AlpenglowIndustries/Alpenglow-SkeinTwister/README.md

# Alpenglow-SkeinTwister
The main open-source hardware repo for the Alpenglow Yarn SkeinTwister.  Start here, repo for the SkeinTwister software is [here](https://github.com/AlpenglowIndustries/SkeinTwisterCode).



Hello my friends.  As one of the final acts of Alpenglow Industries, we are open-sourcing the SkeinTwister design under a permissive CERN open hardware v2 license.  The text of the license is included in this repo, what it practically means is that as long as you attribute our original work, you can reproduce anything in this repo and even sell it.  

The [Alpenglow YouTube channel](https://www.youtube.com/watch?v=4FvFv4GcJJE&list=PLGswnsgctcE1kCAfXg5c3xEA6l_XDLfXw&pp=sAgC) has videos on assembly/disassembly and repair.

Note that we were purchasing parts and materials in large batches, so our sources that are listed in the SkeinTwister BOM spreadsheet may or may not be relevant for you. Use it as a starting point. The ReadMe docs in each folder will have more info about the parts that folder describes.

If you would like to reproduce this design and need help, Carrie Sundra is available to hire for consulting and for manufacturing the custom circuit boards.  You can reach out to her via [Discord](https://discord.com/users/461976578734161920) or [this email](mailto:info@alpenglowyarn.com) for now.  She is willing to do one free 30 minute video chat with anyone who is interested in reproducing the design, after that she may have time available at her hourly consulting rate.
