AlpenglowIndustries/Alpenglow-SkeinTwister/SkeinTwister Motor/ReadMe for Motors.txt

We purchased motors directly from Tsiny, qtys of about 144 at a time.  You can find the same part number on AliExpress purchaseable in small quantities.  They may not have the extra gearbox grease we had them add to the motors we purchased.

We developed a few custom specs for these motor orders:
Motor name: TS-40GZ868-motors-12V 160rpm
Special requirements: multi-point grease coated on the gear box
Packaging: Please ship with the same packaging - 6 motors per tray, no more than 4 trays (24 motors) per box.  Please also make sure that excess room in the box is taken up by material that cannot be further compressed, so that motors cannot move in the box during shipping.
Qty: 144 

Contact:
Avril Luo
Dongguan Tsiny Motor IND CO.,LTD
sales@tsinymotor.com
+86-0769-87736501 / +86-18664005397
www.tsinymotor.com
