AlpenglowIndustries/Alpenglow-SkeinTwister/SkeinTwister Foot Pedal/NewWirePath.jpg

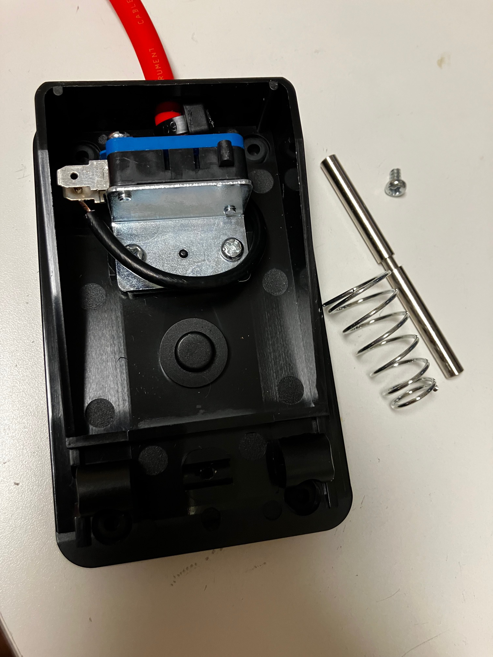
SkeinTwister Foot Pedal/NewWirePath.jpg
