AlpenglowIndustries/Alpenglow-SkeinTwister/SkeinTwister Motor/Tsiny Motor Specs 40GZ868 highlighted.JPG

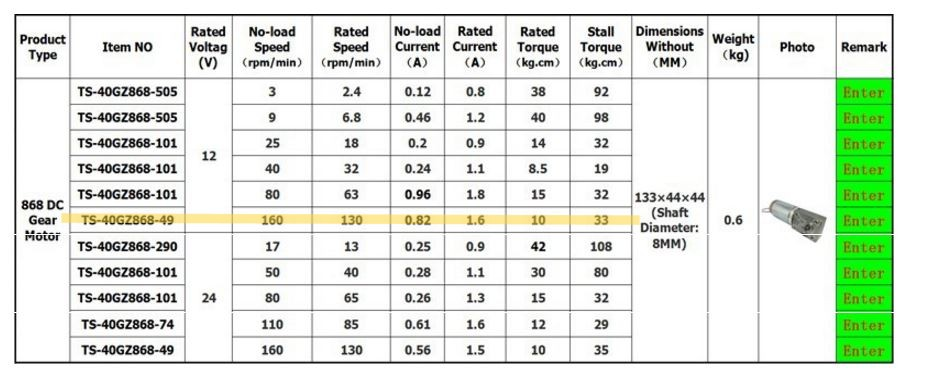
SkeinTwister Motor/Tsiny Motor Specs 40GZ868 highlighted.JPG
