AlpenglowIndustries/Alpenglow-SkeinTwister/SkeinTwister PCB/ST01P01E BOM for JLC.xlsx

Sheet: LCSCBOM
Designator | Type | Footprint | Comment | Quantity | Manufacturer | Manufacturer P/N | Supplier | Supplier P/N | DNP | JLCPCB Part # |  | Basic Man P/N | Basic P/N | Alternate from Macrofab BOM
C2, C3, C5, C6, C7, C9 | CAP | 603 | 0.1 uF capacitor, 10%, 25V, X7R, 0603 pkg | 6 | Samsung | CL10B104KA8NNWC | Digi-Key | 1276-1932-1-ND |  | C14663 | ok to sub | CC0603KRX7R9BB104 | C14663
C1 | CAP | 603 | 1.0 uF capacitor, 10%, 25V, X7R, 0603 | 1 | Samsung | CL10B105KA8NNNC | Digi-Key | 1276-1184-1-ND |  | C15849 | X5R | CL10A105KB8NNNC | C15849
C4 | CAP | 603 | 10 uF capacitor, 10%, 16V, X5R, 0603 | 1 | Murata | GRM188C81C106MA73D | Digi-Key | 490-7198-1-ND |  | C96446 | 25V X5R 10% | CL10A106MA8NRNC | C96446
C8 | CAP | CAP-10MM | 820 uF capacitor, aluminum electrolytic, 25V, 2000 hrs, 595 mA ripple, 20%, 0.394" dia x 0.413" height, smt | 1 | Nichicon | UCM1E821MNL1GS | Digi-Key | 493-14532-1-ND |  | C401766 | ok to sub | EEEFT1E102UP | C401766 | UCM1E821MNL1GS
J2 | CONN | CONN-JACK-2MM_-_SLOTS | 2.5mm x 5.5mm barrel jack, thru-hole pkg | 1 | CUI | PJ-066B | Digi-Key | PJ-066B |  | C500101 | ok to sub | DC-025LBM-5A-2.5 | C500101 | DC-025LM-5A-2.5 | C500102
J4 | CONN | AUDIO-6.35MM-RTA | 1/4" stereo audio jack with switches for plug detection, thru-hole pkg (0.25 ea for 1000 on alibaba) | 1 | Yueqing Binrong Electric Co Ltd | JP-611 | Alibaba | JP-611 |  | C309278 | ok to sub | PJ-611 | C309278
J5 | CONN | DF13C-3P-1.25V | 3-pos DF13 series connector, smt, vertical | 1 | Hirose | DF13C-3P-1.25V(51) | Digi-Key | H121960CT-ND |  | C88352 | ok to sub | DF13C-3P-1.25V(21) | C88352
J1 | CONN | DF13C-6P-1.25V | 6-pos DF13 series connector, smt, vertical | 1 | Hirose | DF13C-6P-1.25V(20) | Digi-Key | H3423-ND |  | C116888
J6 | CONN | OSTTE021104 | Terminal block, 10A, through hole, 2-pos | 1 | On Shore | OSTTE021104 | Digi-Key | ED2748-ND |  | C3817188 | not in stock
J3 | CONN | JST-XH-3 | 3-pos XH series connector, male pins, straight, thru-hole pkg | 1 | JST | B3B-XH-A(LF)(SN) | Digi-Key | 455-2248-ND |  | C144394
D4 | DIODE | SOT-363 | 5.0V TVS steering diode, 4x array, SOT-363 pkg | 1 | Diodes Inc | DT1446-04S-7 | Digi-Key | DT1446-04S-7DICT-ND |  | C443646
D3 | DIODE | SMA | 40V min general purpose diode | 1 | Diodes Inc | SBRT3U60SAF-13 | Digi-Key | SBRT3U60SAF-13DICT-ND |  | C2480 | ok to sub | SS14 | C2480 | MF-DIO-SMA-B140
D2 | DIODE | 0603+ | Diode, red LED, diffused, 2 mA, 4.95 mcd, 0603 | 1 | OSRAM | 150060RS75000 | Digi-Key | 732-4978-1-ND |  | C2286 | ok to sub | KT-0603R | C2286
U1 | IC | SOT-23 | 5V LDO linear regulator, 100 mA, up to 30V input, SOT-23 pkg | 1 | Texas Inst | TLV76050DBZT | Digi-Key | 296-47017-1-ND |  | C2867465 | ok to sub | TLV76050DBZR | C2867465
U2 | IC | TQFP-32 | ATMega 328P, TQFP-32 pkg | 1 | Atmel | ATMEGA328P-AU | Digi-Key | ATMEGA328P-AU-ND |  | C14877
L1 | IND | 603 | ferrite chip, 100 ohms at 100 MHz, 3A, 0603 pkg | 1 | TDK | MPZ1608S101ATAH0 | Digi-Key | 445-1564-1-ND |  | C107332
R6 | RES | 603 | 100 ohm resistor, 1%, 0603 pkg | 1 | Yageo | RC0603FR-07100RL | Digi-Key | 311-100HRCT-ND |  | C25201 | ok to sub | 0603WAJ0101T5E | C25201
R2 | RES | 603 | 1.00k resistor, 1%, 0603 pkg | 1 | Yageo | RC0603FR-071KL | Digi-Key | 311-1.00KHRCT-ND |  | C21190 | ok to sub | 0603WAF1001T5E | C21190
R1, R3, R5 | RES | 603 | 10.0k resistor, 1%, 0603 pkg | 3 | Yageo | RC0603FR-0710KL | Digi-Key | 311-10.0KHRCT-ND |  | C15401 | ok to sub | 0603WAJ0103T5E | C15401
Q1 | TRANS | DFN8_3X3MM | N-channel mosfet, logic level gate, 5 mohm @ 10V, 22nC @ 10V, DFN-8 3x3mm pkg | 1 | Alpha Omega | AON7522E | Digi-Key | 785-1505-1-ND |  | C115844 | ok to sub | AON7534 | C115844 | AON7534
S1 | SWITCH | PB-3.0X2.5-SMT | Pushbutton, 3mm x 2mm, smt | 0 | Omron | B3U-1000P | Digi-Key | SW1020CT-ND | yes
R4 | RES | 603 | 100 ohm resistor, 1%, 0603 pkg | 0 |  |  |  |  | yes

Sheet: OriginalBOM
Designator | Type | Footprint | Comment | Quantity | Manufacturer | Manufacturer P/N | Supplier | Supplier P/N | DNP | JLCPCB Part # |  | Basic Man P/N | Basic P/N | Alternate from Macrofab BOM
C2, C3, C5, C6, C7, C9 | CAP | 603 | 0.1 uF capacitor, 10%, 25V, X7R, 0603 pkg | 6 | Samsung | CL10B104KA8NNWC | Digi-Key | 1276-1932-1-ND |  | C1590 | ok to sub | CC0603KRX7R9BB104 | C14663
C1 | CAP | 603 | 1.0 uF capacitor, 10%, 25V, X7R, 0603 | 1 | Samsung | CL10B105KA8NNNC | Digi-Key | 1276-1184-1-ND |  | C29936 | X5R | CL10A105KB8NNNC | C15849
C4 | CAP | 603 | 10 uF capacitor, 10%, 16V, X5R, 0603 | 1 | Murata | GRM188C81C106MA73D | Digi-Key | 490-7198-1-ND |  | C182375 | 25V X5R 10% | CL10A106MA8NRNC | C96446
C8 | CAP | CAP-10MM | 820 uF capacitor, aluminum electrolytic, 25V, 2000 hrs, 595 mA ripple, 20%, 0.394" dia x 0.413" height, smt | 1 | Nichicon | UCM1E821MNL1GS | Digi-Key | 493-14532-1-ND |  |  |  | EEEFT1E102UP | C401766 | UCM1E821MNL1GS
J2 | CONN | CONN-JACK-2MM_-_SLOTS | 2.5mm x 5.5mm barrel jack, thru-hole pkg | 1 | CUI | PJ-066B | Digi-Key | PJ-066B |  | C3095025 | ok to sub | DC-025LBM-5A-2.5 | C500101 | DC-025LM-5A-2.5 | C500102
J4 | CONN | AUDIO-6.35MM-RTA | 1/4" stereo audio jack with switches for plug detection, thru-hole pkg (0.25 ea for 1000 on alibaba) | 1 | Yueqing Binrong Electric Co Ltd | JP-611 | Alibaba | JP-611 |  | C309278 | ok to sub | PJ-611 | C309278
J5 | CONN | DF13C-3P-1.25V | 3-pos DF13 series connector, smt, vertical | 1 | Hirose | DF13C-3P-1.25V(51) | Digi-Key | H121960CT-ND |  |  | ok to sub | DF13C-3P-1.25V(21) | C88352
J1 | CONN | DF13C-6P-1.25V | 6-pos DF13 series connector, smt, vertical | 1 | Hirose | DF13C-6P-1.25V(20) | Digi-Key | H3423-ND |  | C116888
J6 | CONN | OSTTE021104 | Terminal block, 10A, through hole, 2-pos | 1 | On Shore | OSTTE021104 | Digi-Key | ED2748-ND |  | C3817188 | not in stock
J3 | CONN | JST-XH-3 | 3-pos XH series connector, male pins, straight, thru-hole pkg | 1 | JST | B3B-XH-A(LF)(SN) | Digi-Key | 455-2248-ND |  | C144394
D4 | DIODE | SOT-363 | 5.0V TVS steering diode, 4x array, SOT-363 pkg | 1 | Diodes Inc | DT1446-04S-7 | Digi-Key | DT1446-04S-7DICT-ND |  | C443646
D3 | DIODE | SMA | 40V min general purpose diode | 1 | Diodes Inc | SBRT3U60SAF-13 | Digi-Key | SBRT3U60SAF-13DICT-ND |  |  | ok to sub | SS14 | C2480 | MF-DIO-SMA-B140
D2 | DIODE | 0603+ | Diode, red LED, diffused, 2 mA, 4.95 mcd, 0603 | 1 | OSRAM | 150060RS75000 | Digi-Key | 732-4978-1-ND |  | C3030991 | ok to sub | KT-0603R | C2286
U1 | IC | SOT-23 | 5V LDO linear regulator, 100 mA, up to 30V input, SOT-23 pkg | 1 | Texas Inst | TLV76050DBZT | Digi-Key | 296-47017-1-ND |  | C134013 | ok to sub | TLV76050DBZR | C2867465
U2 | IC | TQFP-32 | ATMega 328P, TQFP-32 pkg | 1 | Atmel | ATMEGA328P-AU | Digi-Key | ATMEGA328P-AU-ND |  | C14877
L1 | IND | 603 | ferrite chip, 100 ohms at 100 MHz, 3A, 0603 pkg | 1 | TDK | MPZ1608S101ATAH0 | Digi-Key | 445-1564-1-ND |  | C107332
R6 | RES | 603 | 100 ohm resistor, 1%, 0603 pkg | 1 | Yageo | RC0603FR-07100RL | Digi-Key | 311-100HRCT-ND |  | C105588 | ok to sub | 0603WAJ0101T5E | C25201
R2 | RES | 603 | 1.00k resistor, 1%, 0603 pkg | 1 | Yageo | RC0603FR-071KL | Digi-Key | 311-1.00KHRCT-ND |  | C22548 | ok to sub | 0603WAF1001T5E | C21190
R1, R3, R5 | RES | 603 | 10.0k resistor, 1%, 0603 pkg | 3 | Yageo | RC0603FR-0710KL | Digi-Key | 311-10.0KHRCT-ND |  | C98220 | ok to sub | 0603WAJ0103T5E | C15401
Q1 | TRANS | DFN8_3X3MM | N-channel mosfet, logic level gate, 5 mohm @ 10V, 22nC @ 10V, DFN-8 3x3mm pkg | 1 | Alpha Omega | AON7522E | Digi-Key | 785-1505-1-ND |  |  | ok to sub | AON7534 | C115844 | AON7534
S1 | SWITCH | PB-3.0X2.5-SMT | Pushbutton, 3mm x 2mm, smt | 0 | Omron | B3U-1000P | Digi-Key | SW1020CT-ND | yes
R4 | RES | 603 | 100 ohm resistor, 1%, 0603 pkg | 0 |  |  |  |  | yes
