AlpenglowIndustries/Alpenglow-SkeinTwister/SkeinTwister PCB/ST01P01E BOM for Quotes.xlsx

RefDes | Type | Description | Quantity | Manufacturer | Manufacturer P/N | Supplier | Supplier P/N
C2, C3, C5, C6, C7, C9 | CAP | 0.1 uF capacitor, 10%, 25V, X7R, 0603 pkg | 6 | Samsung | CL10B104KA8NNWC | Digi-Key | 1276-1932-1-ND
C1 | CAP | 1.0 uF capacitor, 10%, 25V, X7R, 0603 | 1 | Samsung | CL10B105KA8NNNC | Digi-Key | 1276-1184-1-ND
C4 | CAP | 10 uF capacitor, 10%, 16V, X5R, 0603 | 1 | Murata | GRM188C81C106MA73D | Digi-Key | 490-7198-1-ND
C8 | CAP | 820 uF capacitor, aluminum electrolytic, 25V, 2000 hrs, 595 mA ripple, 20%, 0.394" dia x 0.413" height, smt | 1 | Nichicon | UCM1E821MNL1GS | Digi-Key | 493-14532-1-ND
J2 | CONN | 2.5mm x 5.5mm barrel jack, thru-hole pkg | 1 | CUI | PJ-066B | Digi-Key | PJ-066B
J4 | CONN | 1/4" stereo audio jack with switches for plug detection, thru-hole pkg (0.25 ea for 1000 on alibaba) | 1 | Yueqing Binrong Electric Co Ltd | JP-611 | Alibaba | JP-611
J5 | CONN | 3-pos DF13 series connector, smt, vertical | 1 | Hirose | DF13C-3P-1.25V(51) | Digi-Key | H121960CT-ND
J1 | CONN | 6-pos DF13 series connector, smt, vertical | 1 | Hirose | DF13C-6P-1.25V(20) | Digi-Key | H3423-ND
J6 | CONN | Terminal block, 10A, through hole, 2-pos | 1 | On Shore | OSTTE021104 | Digi-Key | ED2748-ND
J3 | CONN | 3-pos XH series connector, male pins, straight, thru-hole pkg | 1 | JST | B3B-XH-A(LF)(SN) | Digi-Key | 455-2248-ND
D4 | DIODE | 5.0V TVS steering diode, 4x array, SOT-363 pkg | 1 | Diodes Inc | DT1446-04S-7 | Digi-Key | DT1446-04S-7DICT-ND
D3 | DIODE | 40V min general purpose diode | 1 | Diodes Inc | SBRT3U60SAF-13 | Digi-Key | SBRT3U60SAF-13DICT-ND
D2 | DIODE | Diode, red LED, diffused, 2 mA, 4.95 mcd, 0603 | 1 | OSRAM | 150060RS75000 | Digi-Key | 732-4978-1-ND
U1 | IC | 5V LDO linear regulator, 100 mA, up to 30V input, SOT-23 pkg | 1 | Texas Inst | TLV76050DBZT | Digi-Key | 296-47017-1-ND
U2 | IC | ATMega 328P, TQFP-32 pkg | 1 | Atmel | ATMEGA328P-AU | Digi-Key | ATMEGA328P-AU-ND
L1 | IND | ferrite chip, 100 ohms at 100 MHz, 3A, 0603 pkg | 1 | TDK | MPZ1608S101ATAH0 | Digi-Key | 445-1564-1-ND
R6 | RES | 100 ohm resistor, 1%, 0603 pkg | 1 | Yageo | RC0603FR-07100RL | Digi-Key | 311-100HRCT-ND
R2 | RES | 1.00k resistor, 1%, 0603 pkg | 1 | Yageo | RC0603FR-071KL | Digi-Key | 311-1.00KHRCT-ND
R1, R3, R5 | RES | 10.0k resistor, 1%, 0603 pkg | 3 | Yageo | RC0603FR-0710KL | Digi-Key | 311-10.0KHRCT-ND
Q1 | TRANS | N-channel mosfet, logic level gate, 5 mohm @ 10V, 22nC @ 10V, DFN-8 3x3mm pkg | 1 | Alpha Omega | AON7522E | Digi-Key | 785-1505-1-ND
 |  |  | 23 | SMT parts (106 pads)
 |  |  | 4 | Through parts (14 pads)
Do not Populate:
S1 | SWITCH | Pushbutton, 3mm x 2mm, smt | 0 | Omron | B3U-1000P | Digi-Key | SW1020CT-ND
R4 | RES | 100 ohm resistor, 1%, 0603 pkg | 0
