AlpenglowIndustries/Alpenglow-SkeinTwister/SkeinTwister Enclosure/ST03M01B.step

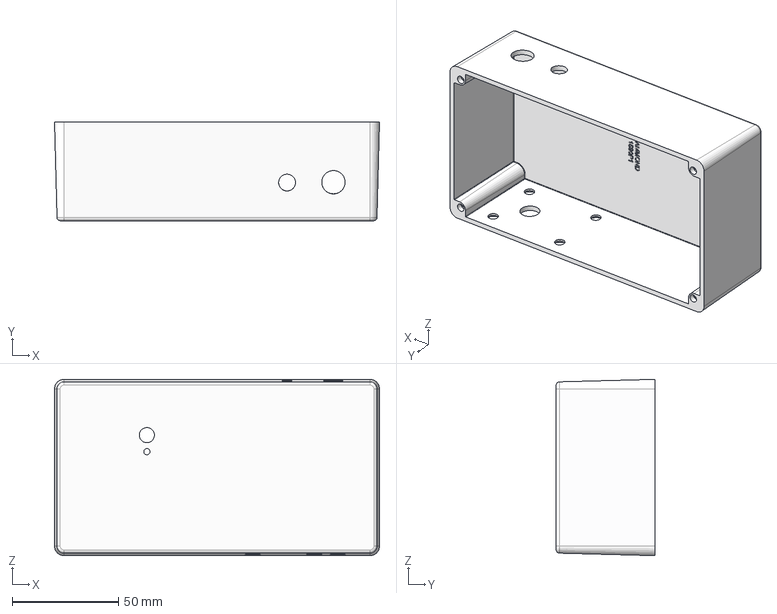
[picture p5: CAD file, 2026-11-03]
SkeinTwister Enclosure/ST03M01B.step
153.0 x 46.4 x 83.0 mm
