AlpenglowIndustries/Alpenglow-SkeinTwister/SkeinTwister Hook/ST01M01D, Hook.step

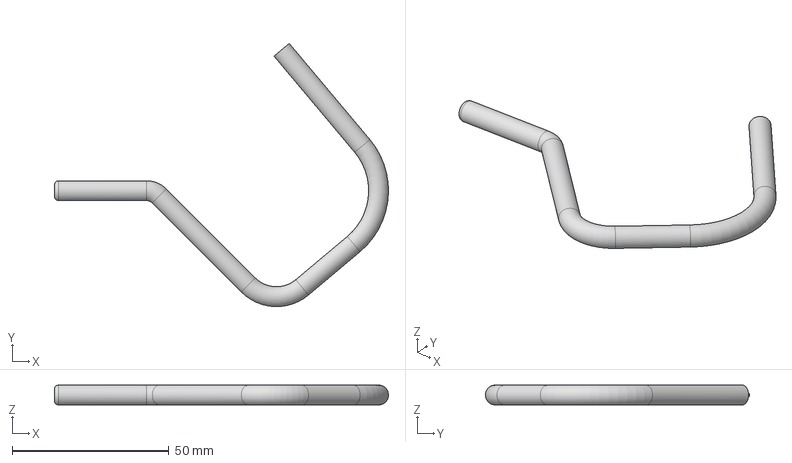
[picture p6: CAD file, 2026-11-03]
SkeinTwister Hook/ST01M01D, Hook.step
106.5 x 84.3 x 6.35 mm
