AlpenglowIndustries/Alpenglow-SkeinTwister/SkeinTwister Knob Assembly/ST04M03E, for MJF process.step

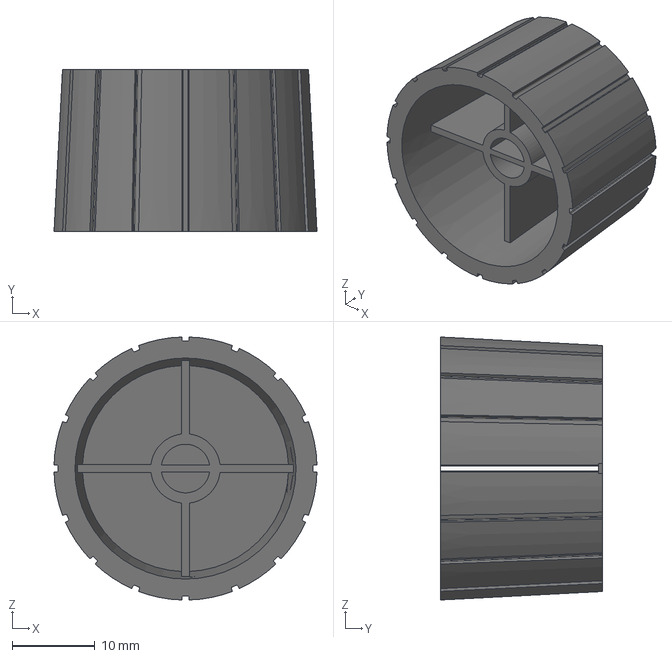
[picture p7: CAD file, 2026-11-03]
SkeinTwister Knob Assembly/ST04M03E, for MJF process.step
31.7 x 19.6 x 31.7 mm
