AlpenglowIndustries/Alpenglow-SkeinTwister/SkeinTwister Motor/TS-40GZ.step

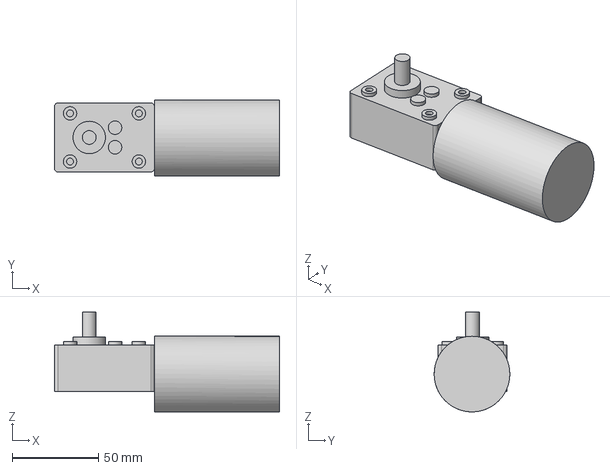
[picture p8: CAD file, 2026-11-03]
SkeinTwister Motor/TS-40GZ.step
130.8 x 44.0 x 58.0 mm
Motor Spacer
Motor
