AlpenglowIndustries/Alpenglow-SkeinTwister/SkeinTwister Overlay Label/ST05M01.step

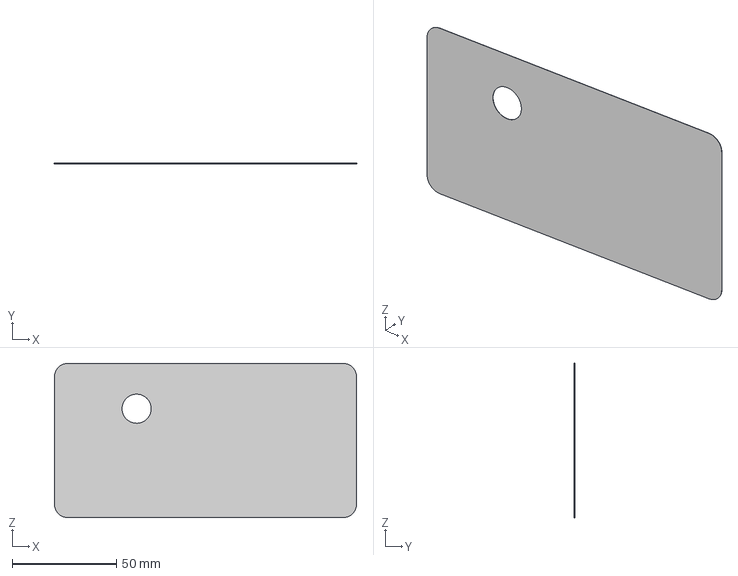
[picture p9: CAD file, 2026-11-03]
SkeinTwister Overlay Label/ST05M01.step
144.8 x 0.127 x 73.9 mm
