AlpenglowIndustries/Alpenglow-SkeinTwister/SkeinTwister PCB/ST01P01C.step

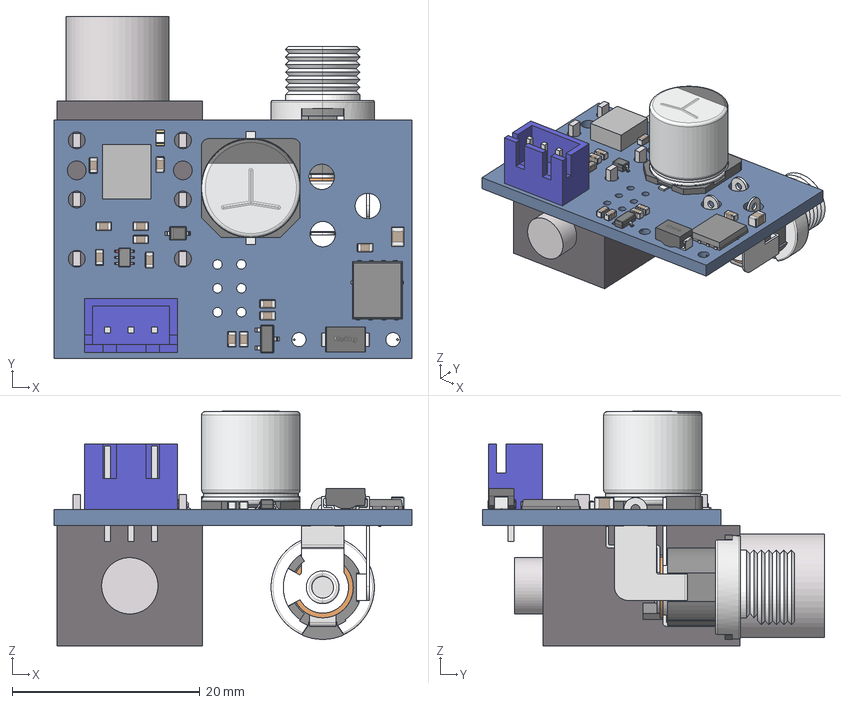
[picture p10: CAD file, 2026-11-03]
SkeinTwister PCB/ST01P01C.step
38.1 x 36.4 x 25.0 mm
Board
STEP-WE-TVSP-DO214-AC-400W_BI-rev1
pj-067a x 5
B3B-XH-AM
Extruded x 9
User_Library-TDSON-8_(INFIN)
SC70-6_(SOT363)
