AlpenglowIndustries/Alpenglow-SkeinTwister/SkeinTwister Wood Base/Wood Base.step

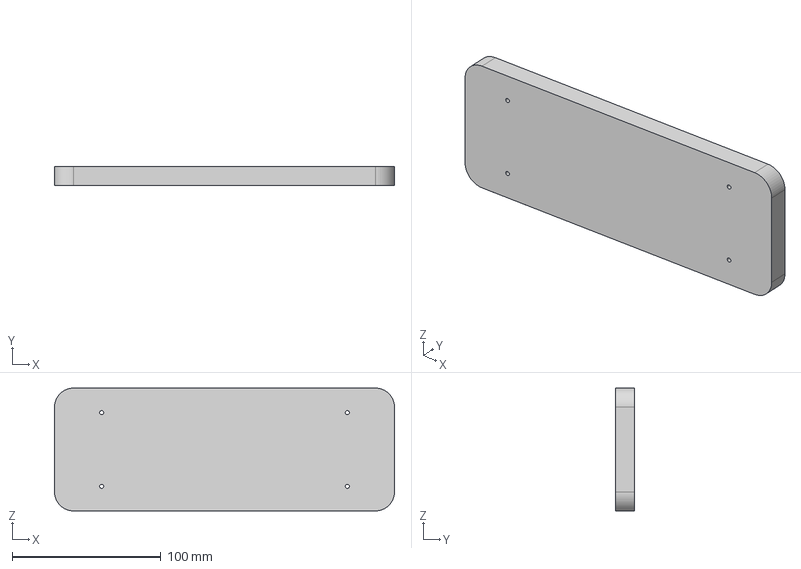
[picture p11: CAD file, 2026-11-03]
SkeinTwister Wood Base/Wood Base.step
228.6 x 12.7 x 82.5 mm
