AlpenglowIndustries/Alpenglow-SkeinTwister/SkeinTwister Knob Assembly/p160kn.stp

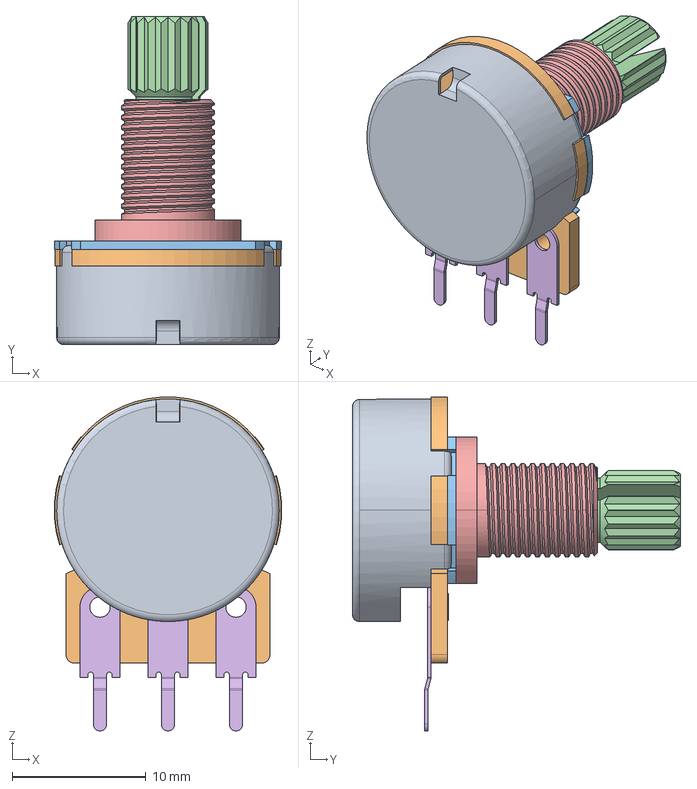
[picture p12: CAD file, 2026-11-03]
SkeinTwister Knob Assembly/p160kn.stp
17.0 x 24.5 x 25.0 mm
BM-251
BM-252
BM-253
BM-239-12
BM-254-1
BM-396 x 3
