AlpenglowIndustries/Alpenglow-SkeinTwister/SkeinTwister Motor Spacer/ST04M01D, Motor Spacer.dxf

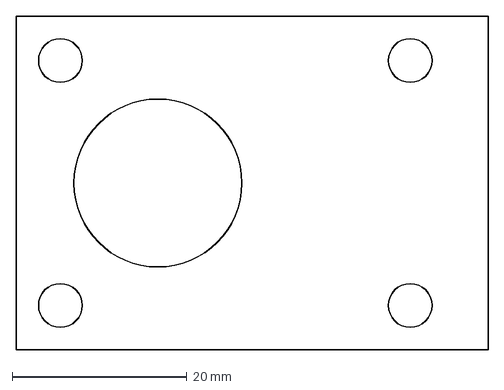
[picture p13: CAD file, 2026-11-03]
SkeinTwister Motor Spacer/ST04M01D, Motor Spacer.dxf
54.0 x 38.1 mm
