AlpenglowIndustries/Alpenglow-SkeinTwister/SkeinTwister Overlay Label/Overlay Label v2.dxf

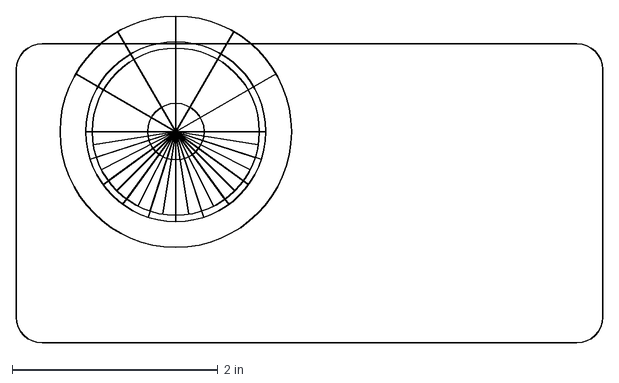
[picture p14: CAD file, 2026-11-03]
SkeinTwister Overlay Label/Overlay Label v2.dxf
5.70 x 3.18 in
