AlpenglowIndustries/Alpenglow-SkeinTwister/SkeinTwister Wood Base/ST03M02B, Wood Base.dxf

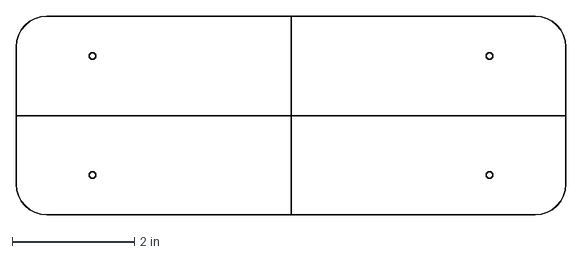
[picture p15: CAD file, 2026-11-03]
SkeinTwister Wood Base/ST03M02B, Wood Base.dxf
9.00 x 3.25 in
