AlpenglowIndustries/Alpenglow-SkeinTwister/SkeinTwister Knob Assembly/ST04M03E for MJF v6.stl

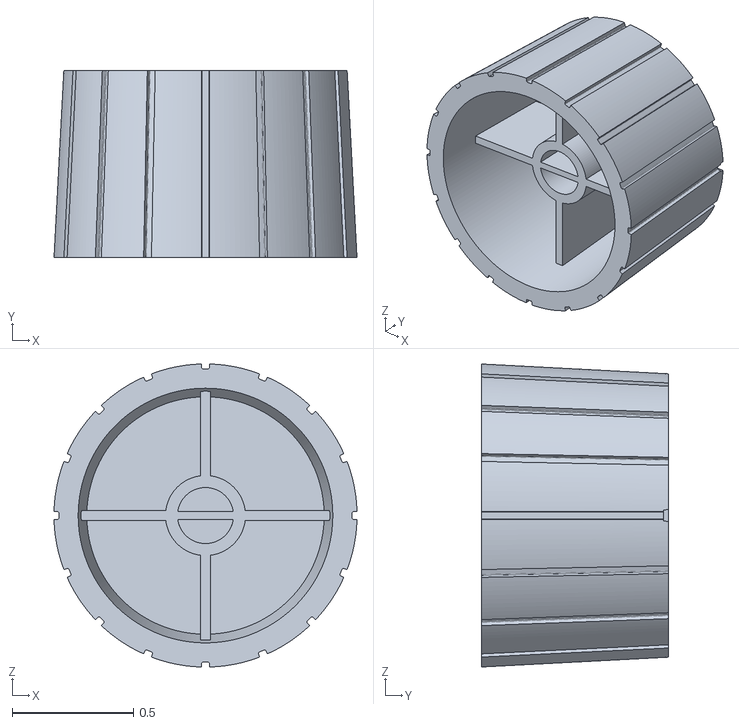
[picture p16: CAD file, 2026-11-03]
SkeinTwister Knob Assembly/ST04M03E for MJF v6.stl
1.25 x 0.77 x 1.25
