AlpenglowIndustries/Alpenglow-SkeinTwister/(list of files, cad)

Other CAD files:
SkeinTwister Motor Spacer/Motor Spacer.step
SkeinTwister Enclosure/ST03M01B, Enclosure Assembly.f3z
SkeinTwister Enclosure/ST03M01B.f3d
SkeinTwister Hook/ST01M01D, Hook.f3d
SkeinTwister Knob Assembly/ST04M03E, for MJF process.f3d
SkeinTwister Motor Spacer/Motor Spacer.f3d
SkeinTwister Motor Spacer/Motor Spacer.stl
SkeinTwister Motor/TS-40GZ.f3d
SkeinTwister Overlay Label/ST05M01.f3d
SkeinTwister Wood Base/Wood Base.f3d
