AlpenglowIndustries/Alpenglow-SkeinTwister/SkeinTwister Foot Pedal/2024 foot pedal assembly/20240917_093545.jpg

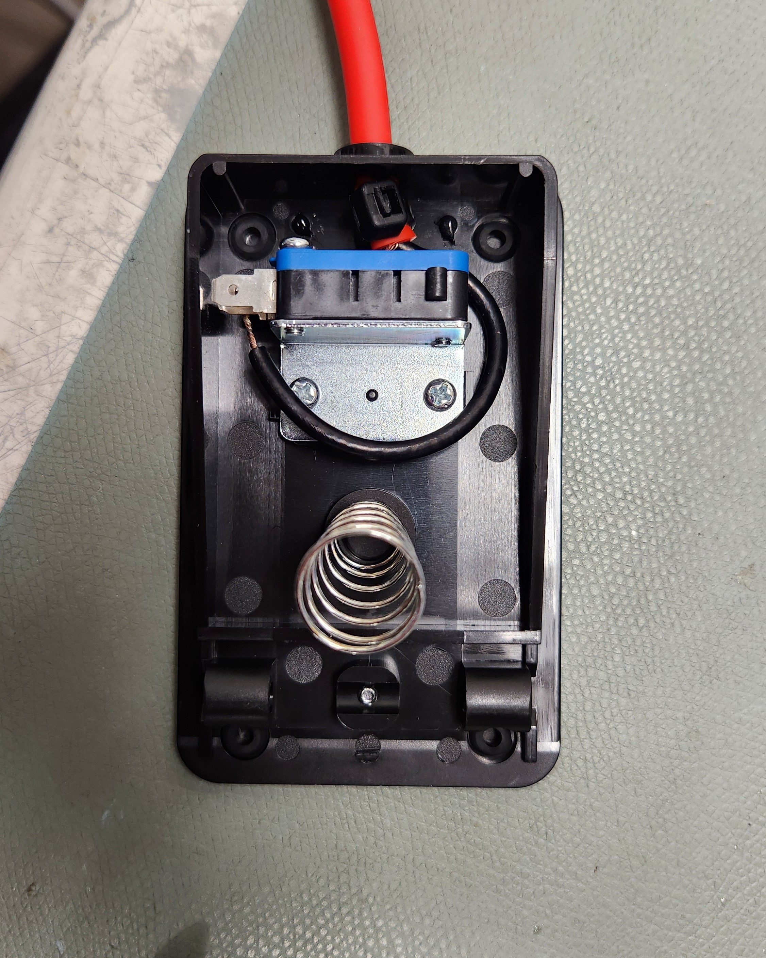
SkeinTwister Foot Pedal/2024 foot pedal assembly/20240917_093545.jpg
