AlpenglowIndustries/Alpenglow-SkeinTwister/SkeinTwister Foot Pedal/2024 foot pedal assembly/20240923_100717.jpg

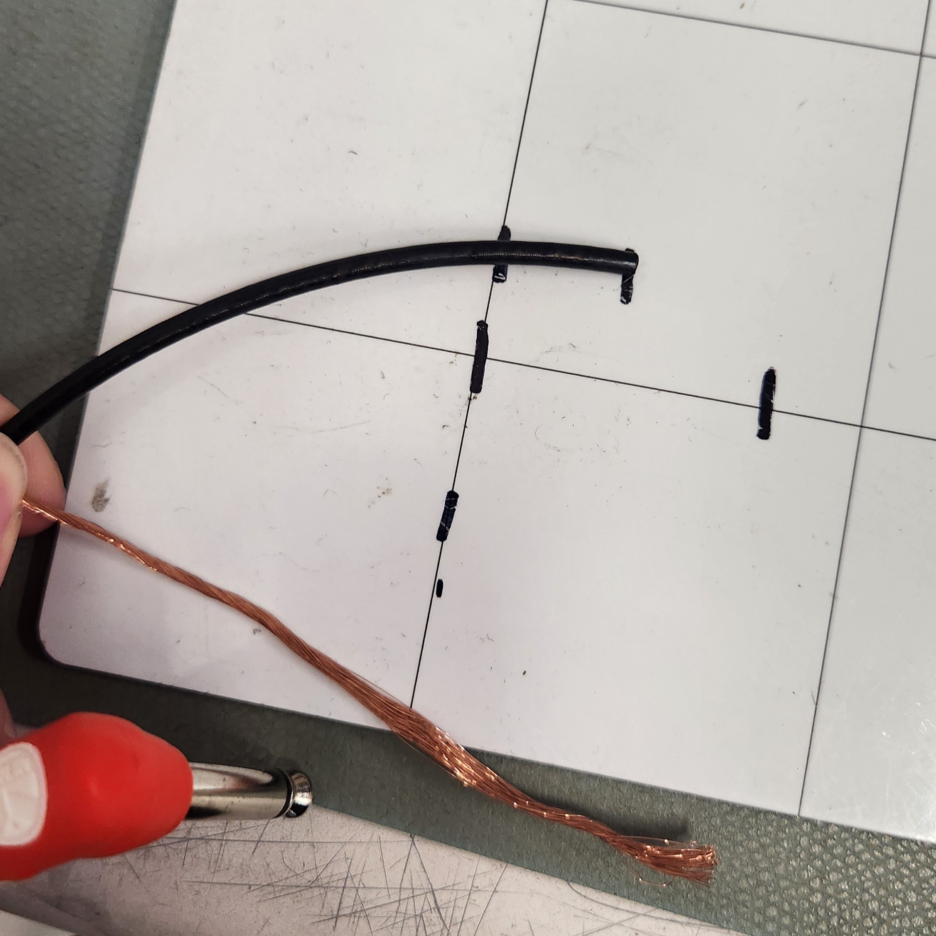
SkeinTwister Foot Pedal/2024 foot pedal assembly/20240923_100717.jpg
