AlpenglowIndustries/Alpenglow-SkeinTwister/SkeinTwister Knob Assembly/SkeinTwister Knob Cable.png

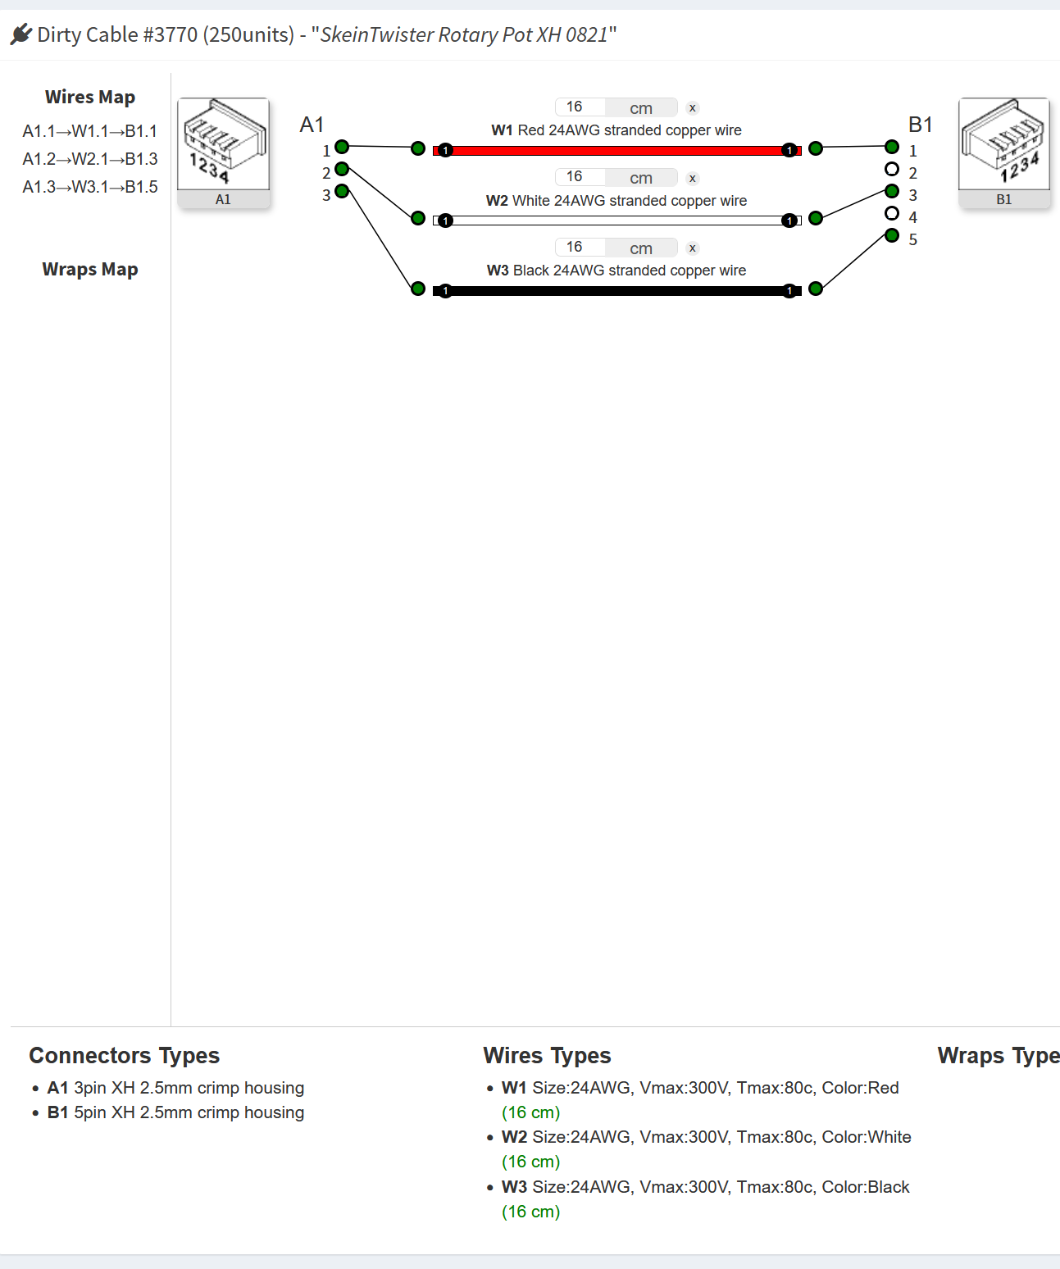
SkeinTwister Knob Assembly/SkeinTwister Knob Cable.png
