AlpenglowIndustries/Alpenglow-SkeinTwister/SkeinTwister PCB/SkeinTwister Rev E Schematic.pdf

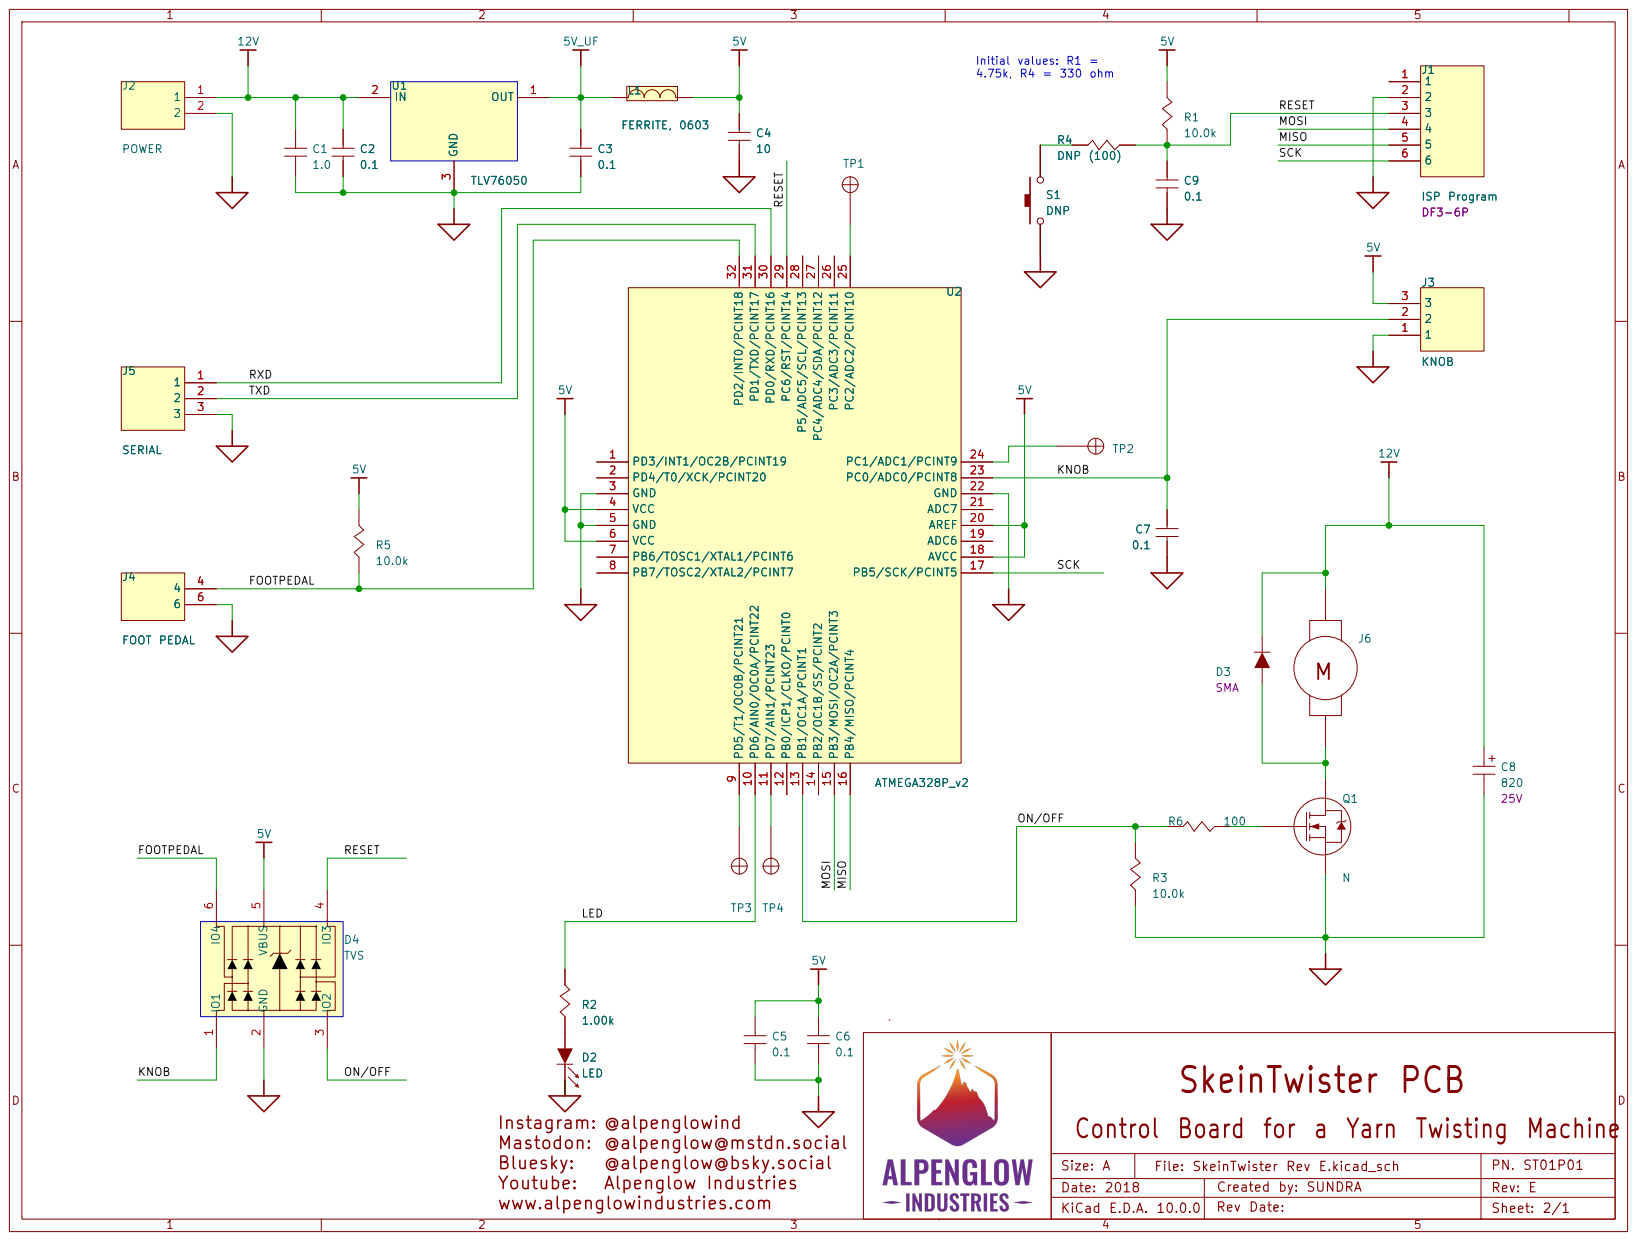
[picture p64: page 1]

9 PD6/AIN0/OC0A/PCINT22 10 PD7/AIN1/PCINT23 11 PB0/ICP1/CLKO/PCINT0 12 PB1/OC1A/PCINT1 13 PB2/OC1B/SS/PCINT2 14 PB3/MOSI/OC2A/PCINT3 15 PB4/MISO/PCINT4 16

Control Board for a Yarn Twisting Machine
