AlpenglowIndustries/Alpenglow-SkeinTwister/SkeinTwister Enclosure/ST03M01B, Enclosure Drawing.pdf

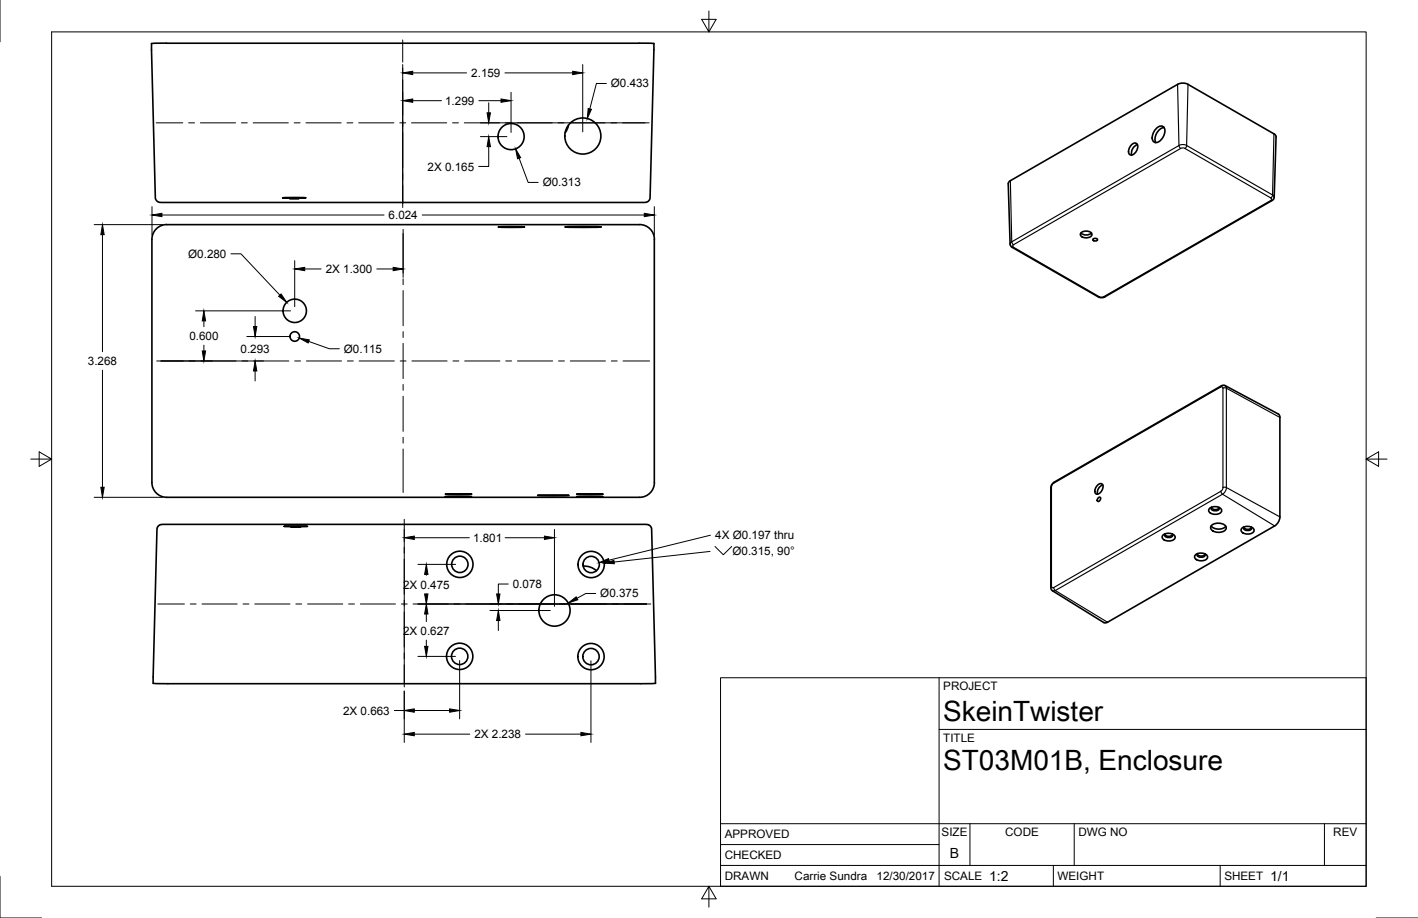
[picture p65: page 1]
SIZE; CODE; DWG NO; REV; Carrie Sundra 12/30/2017; ST03M01B, Enclosure; 4X Ø0.197 thru Ø0.315, 90°
