AlpenglowIndustries/Alpenglow-SkeinTwister/SkeinTwister Hook/ST01M01D, Hook Drawing.pdf

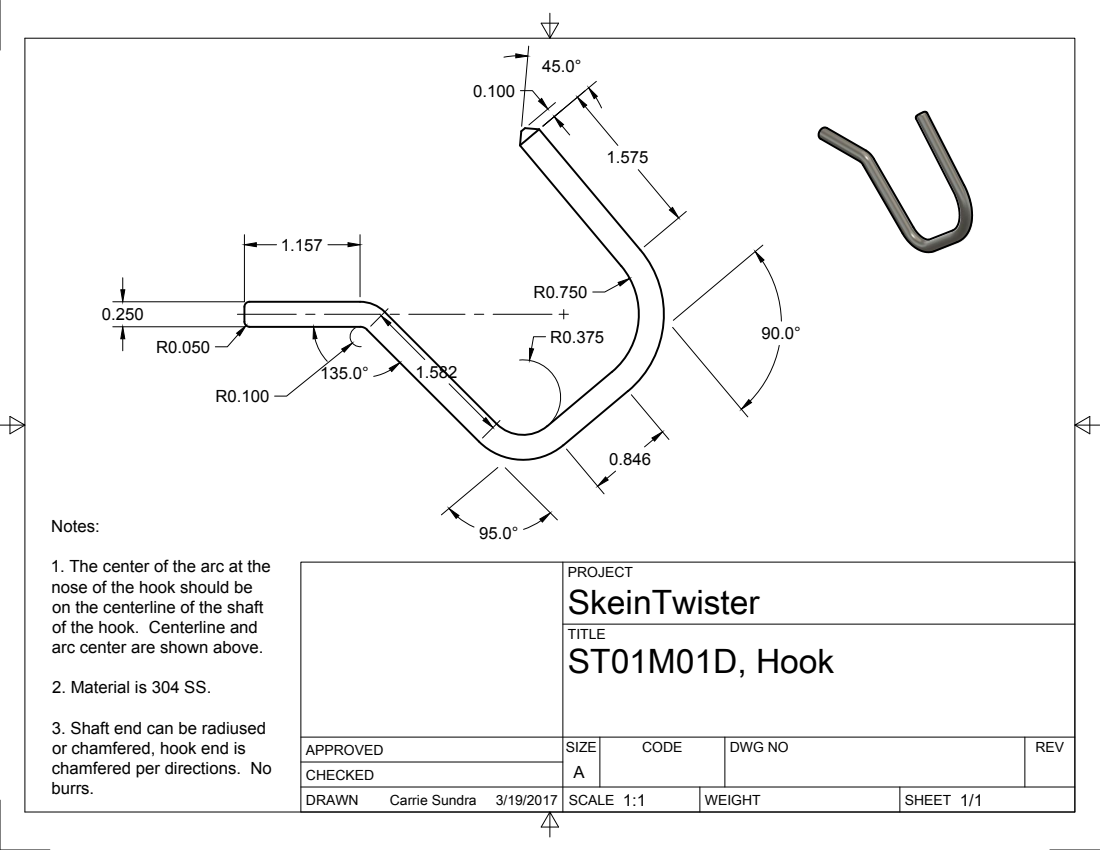
[picture p66: page 1]
SIZE; CODE; DWG NO; REV; Carrie Sundra; ST01M01D, Hook

1. The center of the arc at the
nose of the hook should be
on the centerline of the shaft
of the hook. Centerline and
arc center are shown above.

2. Material is 304 SS.

3. Shaft end can be radiused
or chamfered, hook end is
chamfered per directions. No
burrs.
