AlpenglowIndustries/Alpenglow-SkeinTwister/SkeinTwister Overlay Label/ST05M01C, Label Drawing v3.pdf

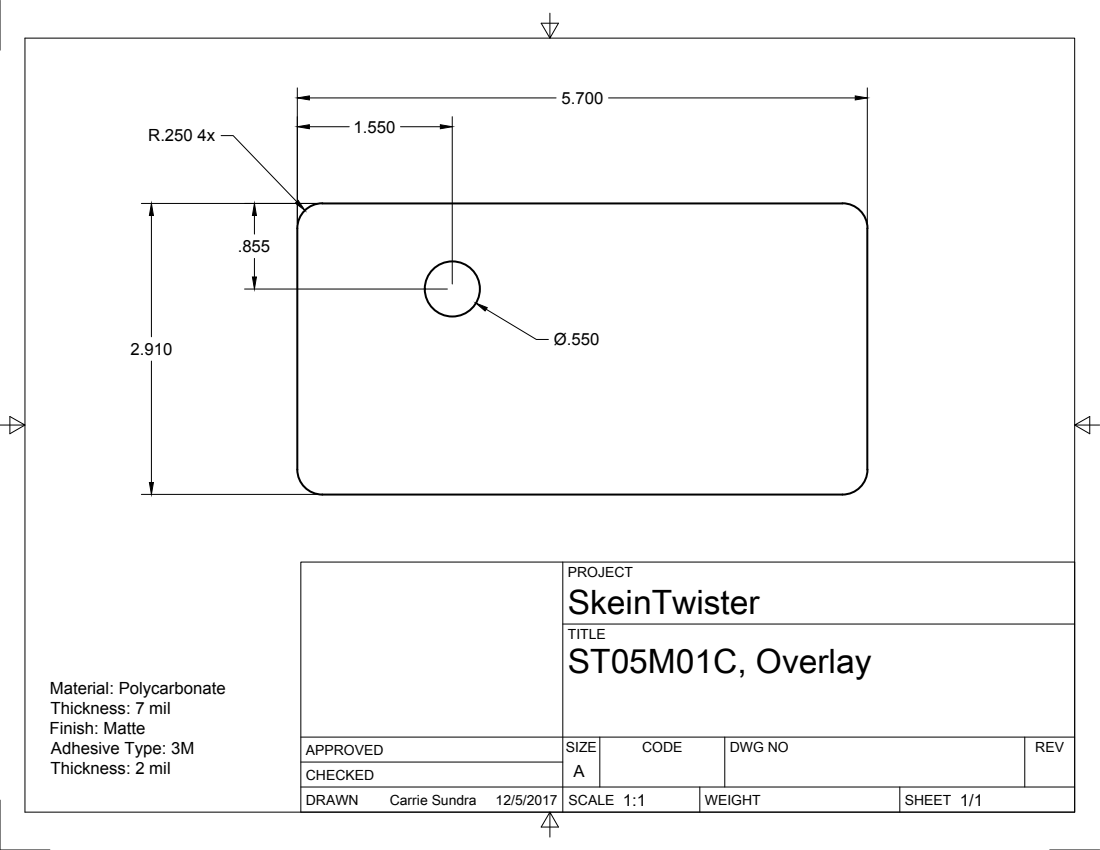
[picture p67: page 1]
SIZE; CODE; DWG NO; REV; Carrie Sundra; ST05M01C, Overlay; Material: Polycarbonate Thickness: 7 mil Finish: Matte Adhesive Type: 3M Thickness: 2 mil
