AlpenglowIndustries/Alpenglow-SkeinTwister/SkeinTwister Knob Assembly/ST04M03Ev6, for MJF process Drawing.pdf

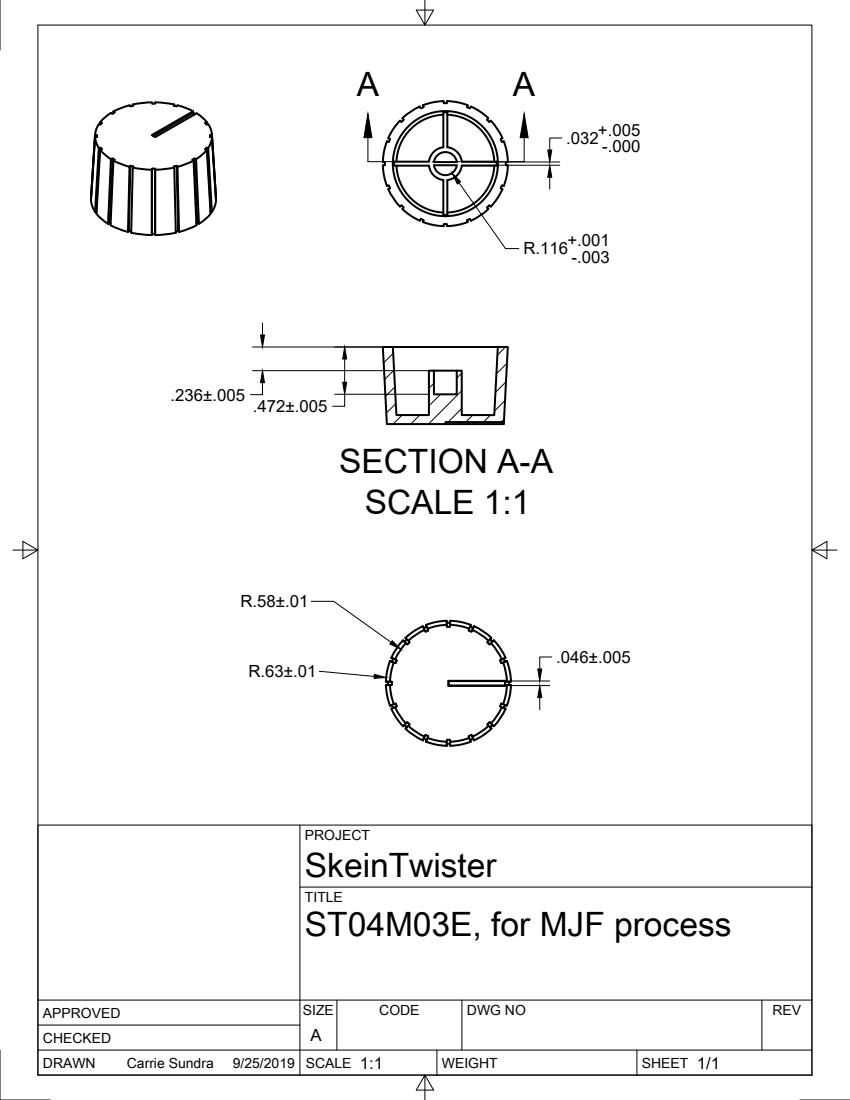
[picture p68: page 1]
SIZE; CODE; DWG NO; REV; Carrie Sundra; SECTION A-A SCALE 1:1

PROJECT
SkeinTwister
ST04M03E, for MJF process
