AlpenglowIndustries/Alpenglow-SkeinTwister/SkeinTwister Enclosure/Skeintwister-Serial-Number Final.pdf

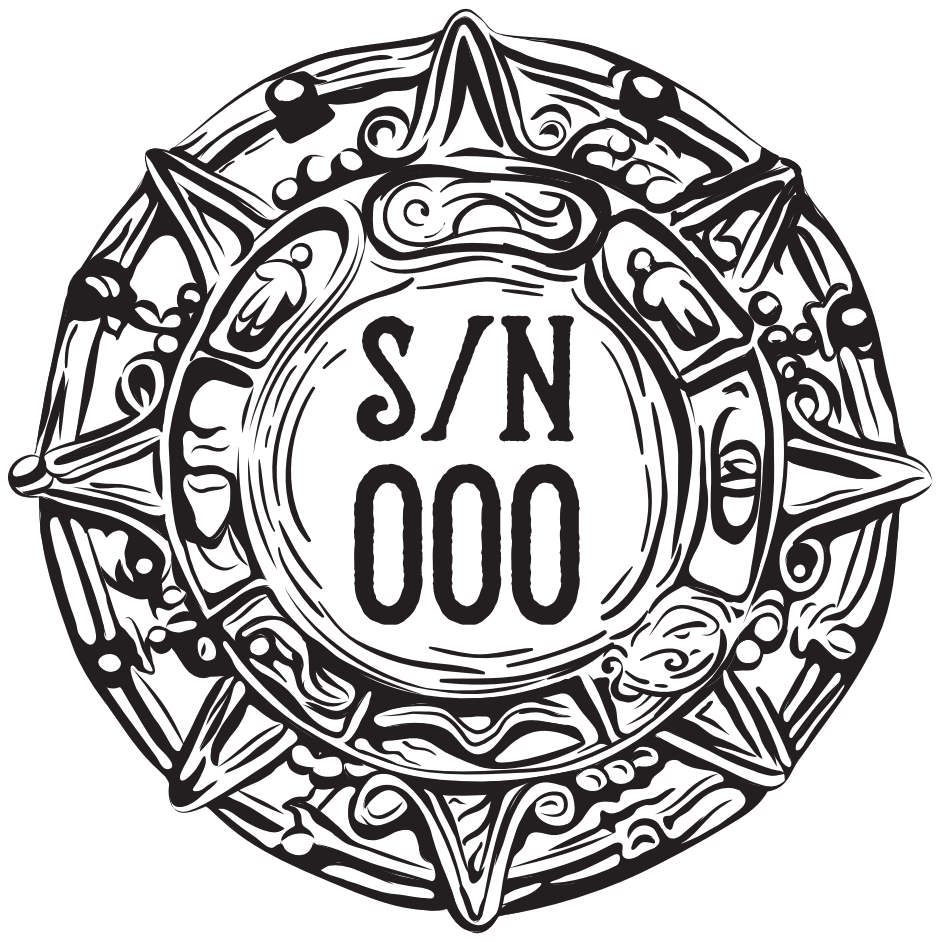
[picture p69: page 1]
