AlpenglowIndustries/Alpenglow-SkeinTwister/SkeinTwister Enclosure/Skeintwister-Serial-Number-Sticker.pdf

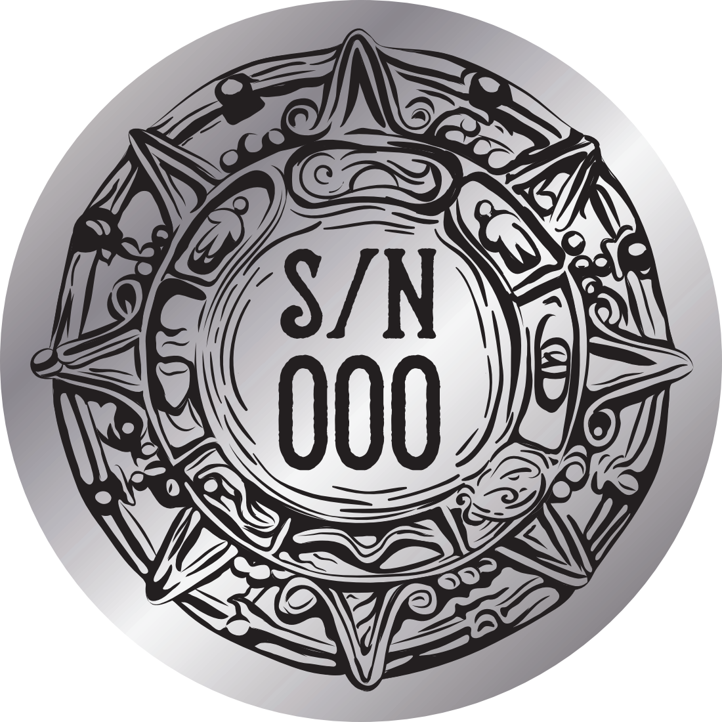
[picture p70: page 1]

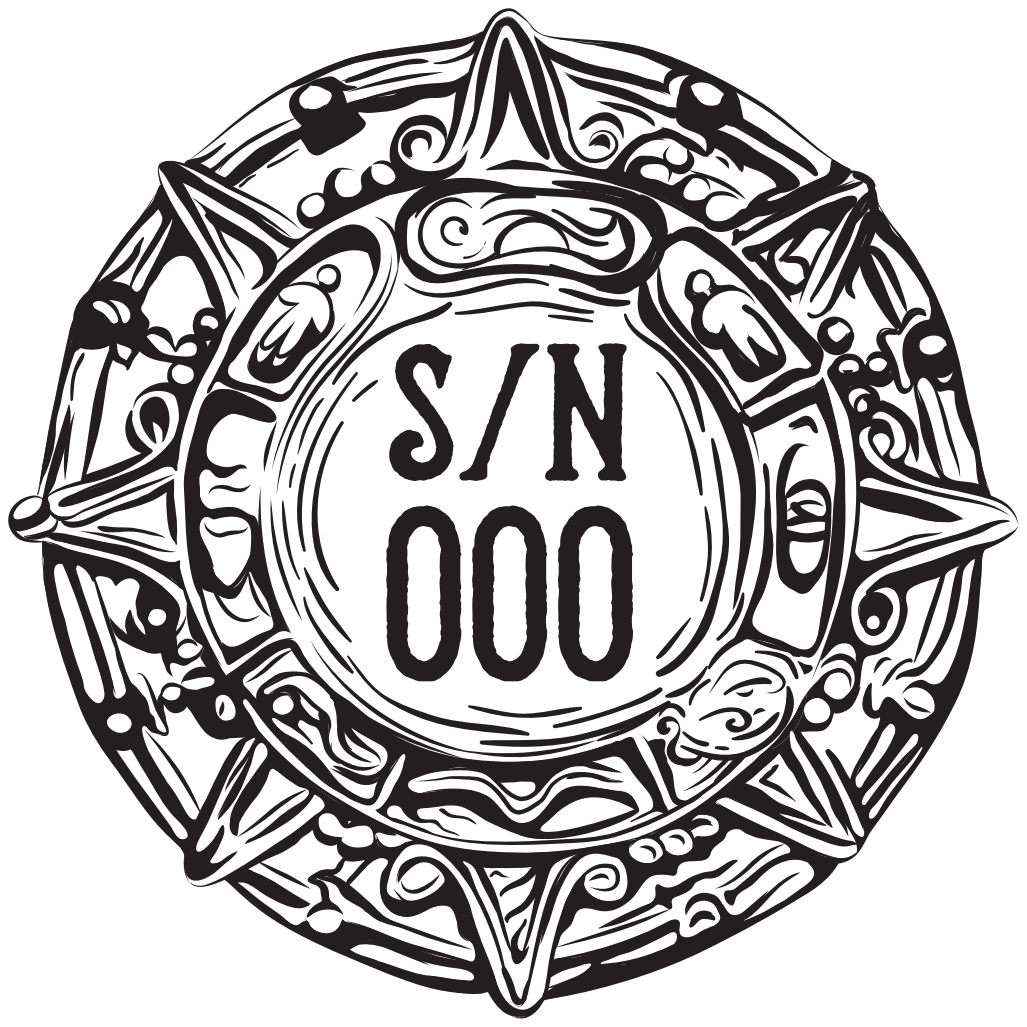
[picture p71: page 2]
