AlpenglowIndustries/Alpenglow-SkeinTwister/SkeinTwister Overlay Label/Skeintwister-Label-Final-Bleeds.pdf

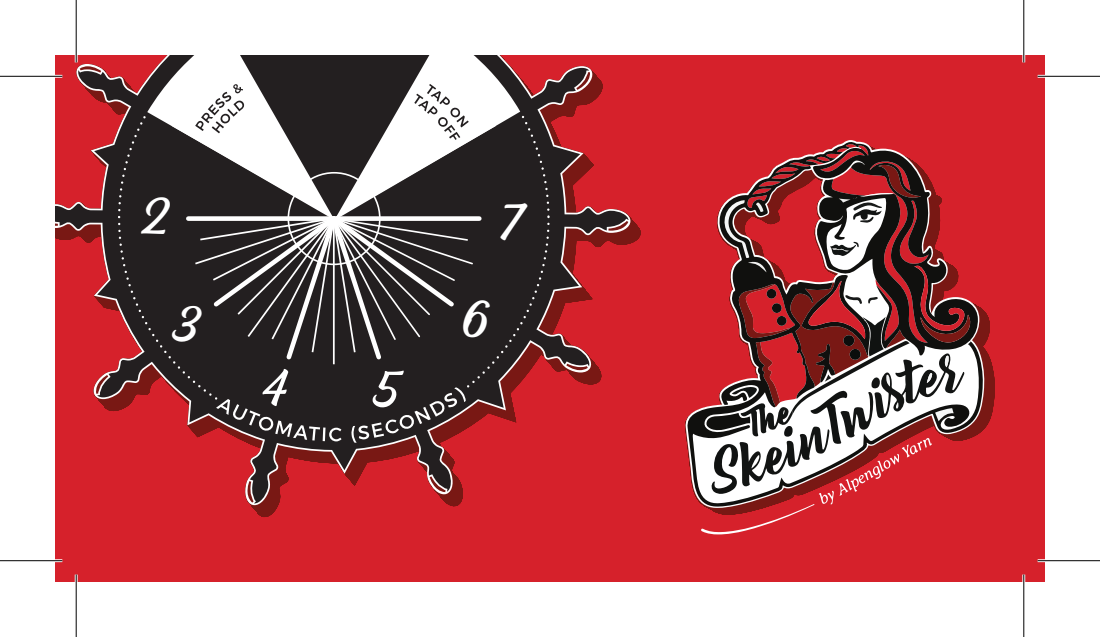
[picture p72: page 1]
