AlpenglowIndustries/Alpenglow-SkeinTwister/SkeinTwister Overlay Label/Skeintwister-Label-Final.pdf

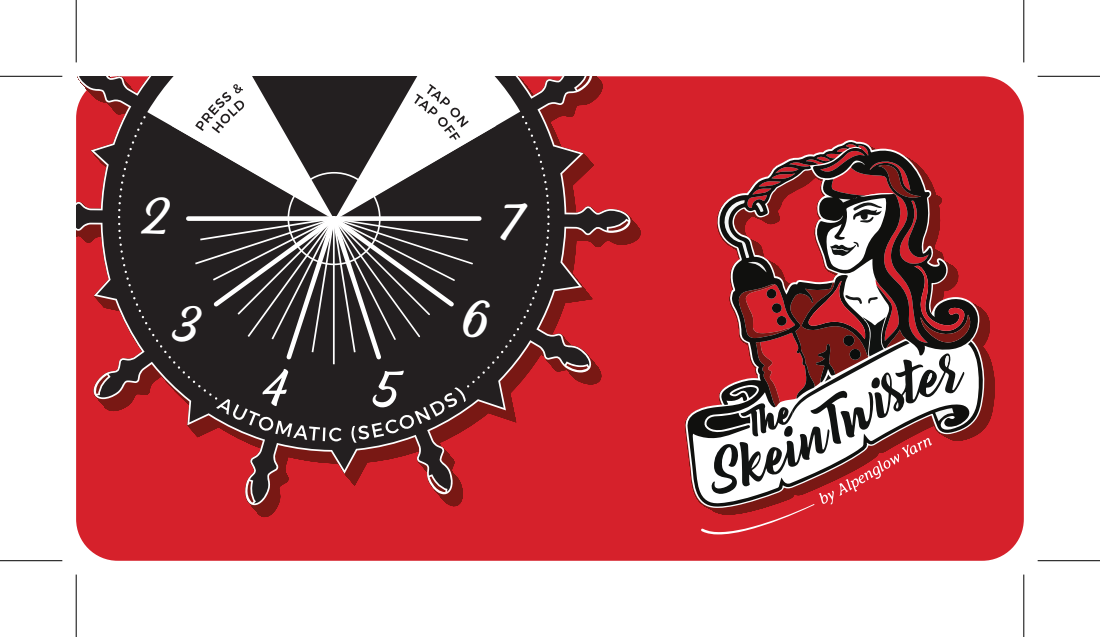
[picture p73: page 1]
