AlpenglowIndustries/Alpenglow-SkeinTwister/SkeinTwister Wood Base/ST03M02B, Wood Base Drawing.pdf

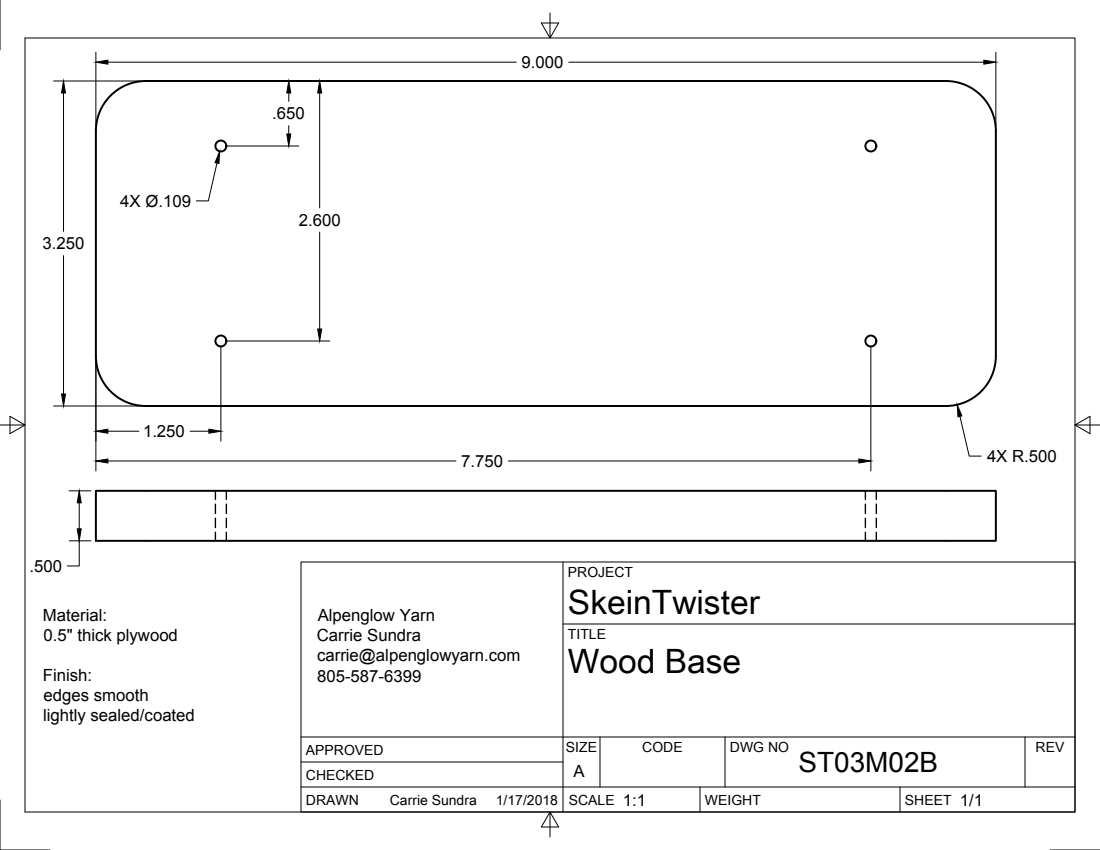
[picture p74: page 1]
SIZE; CODE; DWG NO; REV; Carrie Sundra; Wood Base; 0.5" thick plywood

Alpenglow Yarn
Carrie Sundra
carrie@alpenglowyarn.com

Finish:
edges smooth
lightly sealed/coated
