AlpenglowIndustries/Alpenglow-SkeinTwister/(list of files, drawings)

Other design files:
SkeinTwister PCB/Altium Files/SkeinTwister Rev E.PrjPcb
SkeinTwister PCB/Altium Files/SkeinTwisterRevE.SchDoc
SkeinTwister PCB/Altium Files/ST01P01E.PcbDoc
