AlpenglowIndustries/Alpenglow-SkeinTwister/SkeinTwister PCB/KiCad Import/SkeinTwister Rev E.kicad_pcb

## KiCad design SkeinTwister PCB/KiCad Import/SkeinTwister Rev E.kicad_pcb (2026-11-05)

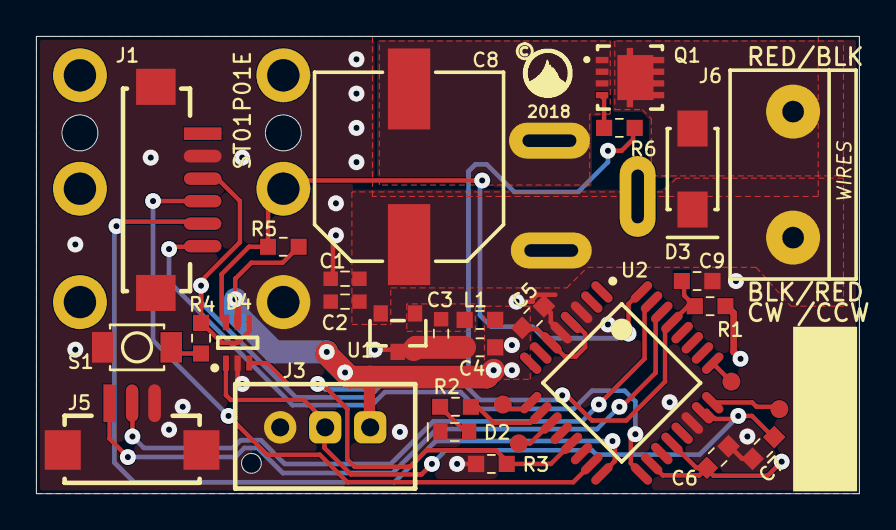
[picture p75: board SkeinTwister Rev E.kicad_pcb from above]

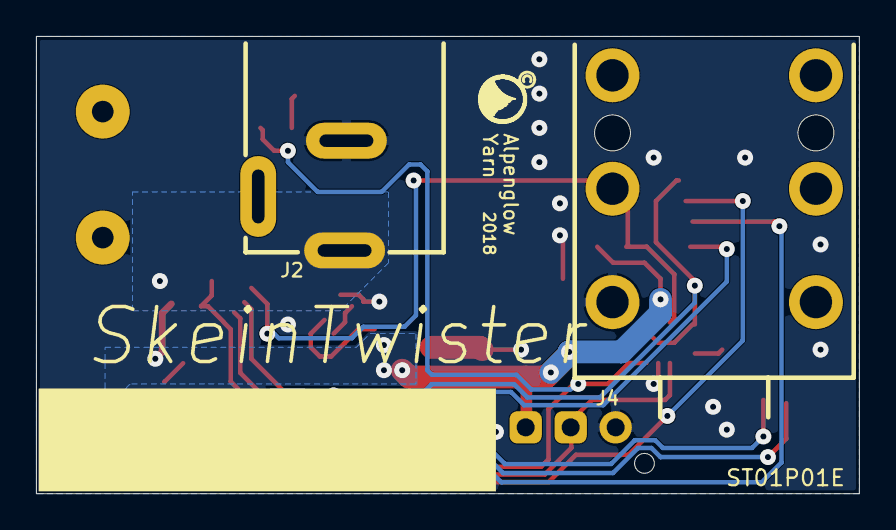
[picture p76: board SkeinTwister Rev E.kicad_pcb from below]

Board: 2 copper layers, 45.7 x 25.4 mm, 33 parts (2 on the bottom side), 22 nets.

Parts:
C1: 1.0; 0603
C2, C3, C5, C6, C7, C9: 0.1; 0603
C4: 10; 0603
C8: 820; CAP-10MM
D2: LED; 0603+
D3: DIODE, SM SIG; SMA
D4: TVS; SOT-363
J1: ISP Program; DF13C-6P-1.25V
J2: POWER; CONN-JACK-2MM - slots - M3
J3: KNOB; JST-XH-3
J4: FOOT PEDAL; AUDIO-6.35MM-RTA
J5: SERIAL; DF13C-3P-1.25V
J6: ?; OSTTE021104
L1: FERRITE, 0603; 0603
Q1: N; DFN8_3X3MM
R1, R3, R5: 10.0k; 0603
R2: 1.00k; 0603
R4: DNP (100); 0603
R6: 100; 0603
S1: DNP; PB-3.0X2.5-SMT
TP1, TP2, TP3, TP4: TESTPOINT; TP-1.0MM
U1: TLV76050; SOT-23
U2: ATMEGA328P_v2; TQFP-32

Connections:
5V: C4.1, C5.1, C6.1, D4.5, J3.3, L1.2, R1.2, R5.2, U2.4, U2.6, U2.18, U2.20
5V_UF: C3.1, L1.1, U1.1
12V: C1.1, C2.1, C8.1, D3.K, J2.1, J6.1, U1.2
FOOTPEDAL: D4.6, J4.4, R5.1, U2.32
GND: C1.2, C2.2, C3.2, C4.2, C5.2, C6.2, C7.2, C8.2, C9.2, D2.2, D4.2, J1.2, J1.7, J1.8, J2.2, J3.1, J4.6, J5.3, J5.4, J5.5, Q1.S, R3.1, S1.1, U1.3, U2.3, U2.5, U2.22
KNOB: C7.1, D4.1, J3.2, U2.23
LED: R2.2, U2.10
MISO: J1.5, U2.16
MOSI: J1.4, U2.15
NetD2_1: D2.1, R2.1
NetD3_A: D3.A, J6.2, Q1.D
NetQ1_G: Q1.G, R6.1
NetR4_2: R4.2, S1.2
NetTP1_1: TP1.1, U2.25
NetTP2_1: TP2.1, U2.24
NetTP3_1: TP3.1, U2.9
NetTP4_1: TP4.1, U2.11
ON/OFF: D4.3, R3.2, R6.2, U2.13
RESET: C9.1, D4.4, J1.3, R1.1, R4.1, U2.29
RXD: J5.1, U2.30
SCK: J1.6, U2.17
TXD: J5.2, U2.31
