AlpenglowIndustries/Alpenglow-SkeinTwister/(commit log)

2026-11-03 initial file upload
    [AlpenglowSkeinTwisterBOM.xlsx, Motor Spacer.f3d, Motor Spacer.step, Motor Spacer.stl, Overlay Label v2.dxf, Pick Place BOM for ST01P01E JLC.csv, Pick Place for ST01P01E.csv, ST01M01D, Hook.f3d]
2026-11-05 added a KiCad conversion for original Altium PCB files, added a schematic pdf, added BOM as csv
    [AlpenglowSkeinTwisterBOM.csv, SkeinTwister Rev E.kicad_pcb, SkeinTwister Rev E.kicad_sch]
2026-11-05 added gitignore for KiCad directory
